Altair-ajit/yondu/(commit log)

2026-07-21 Yondu capstone: hardware record, rebuild spec, and live whistle-flight demo
    - hardware/: ESP32 I2S mic transmitter, Raspberry Pi FFT signal processor
    with JSON configs, Arduino rover sketch recovered from the report appendix
    - docs/: final capstone report (markdown), full hardware rebuild spec (BOM,
    wiring, setup, calibration procedure), architecture doc, expo poster
    - web/: browser simulation of the report's proposed continuous-control mode:
    microphone pitch detection (MPM autocorrelation), 4-step whistle-print
    calibration, gesture classification, and a canvas yaka arrow with plasma
    trail; synth autopilot demo mode; analysis clocked to the audio timeline
    so it is render-rate and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
2026-07-21 Tighten flight handling: always-on drag and damped wall bounces
    - Drag now applies continuously (1.1/s powered, 2.4/s coasting) so the
    arrow answers the whistle instead of skating on momentum; thrust bumped
    to 400 to keep cruise lively
    - Edges are soft walls with a damped bounce (0.72) instead of wrap-around
    teleporting; idle attract mode steers back toward center near edges
2026-07-21 Halve calibration length (~14s -> ~7.5s)
    40 silence frames and 45 voiced frames per step (~1.6-1.8s each at the
    25 Hz analysis cadence) — still ample data for the median/percentile
    signature math; verified within 1% of synth ground truth.
2026-07-21 Add build-the-device field manual page to the web demo
    - web/build.html + build.css: setup-focused companion page in the same
    cockpit design language — signal-chain overview, BOM, wiring tables,
    firmware flashing + command codes, Pi receiver setup, and the env_scan ->
    config.json procedure for remapping the system to control any serial
    device (with the whistle-print schema bridge to the simulator)
    - Citation: UMD ECE / ENEE 408J / Prof. Beaudoin, Rajit Mukhopadhyay first
    followed by teammates, on both the manual and the sim landing card
    - Demo HUD "hardware & docs" button now opens the manual; dev server
    re-rooted at repo root so relative hardware/ links resolve like Pages
    Co-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
2026-07-21 Pitch-style control on hardware: tiled whistle-print export + manual section
    - calibration.js toConfig() now exports three bands that tile the whole
    calibrated range at the sim's dead-zone boundaries (with 1% edge insets),
    so the downloaded whistle print drives the stock Pi signal processor
    exactly like the demo: A=hold/forward, C=up/right, D=down/left, 0=stop.
    Verified by replaying the Pi's matching logic over a full-range sweep —
    every frequency lands in exactly one band.
    - build.html section 06 "Pitch control": gesture->code->rover mapping table,
    5-step sim-to-rover setup, and whistle-band/PWM tuning notes; team
    section renumbered to 07.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
2026-07-21 Rewrite build guide in second person with the rover as worked example
    The page now teaches "what you can build" — a general audio-frequency
    control system — with the capstone rover threaded through as the example
    actuator (parts, wiring, firmware template, code map). Adds live Pages
    demo + build-guide links to the README.
2026-07-21 Add portfolio preview recorder (playwright + ffmpeg)
    scripts/record-preview.mjs drives the autopilot demo headlessly and trims
    the recording to a 12 s flight-only loop: previews/yondu.{webm,mp4} +
    first-frame poster. Preview artifacts stay untracked.
2026-07-21 Preview clip now includes the calibration story
    Trim from the demo click instead of the flight tail: landing card ->
    4-step calibration -> flight, 14.7 s total (still muted, mp4 0.27 MB).
2026-07-21 Lead with the control system, not the rover
    Landing card and README now describe the capstone as a configurable
    audio-to-command control system, with the rover as its demo actuator.
